edgeggrr/Miners-Safety-Helmet/images/PCB.png

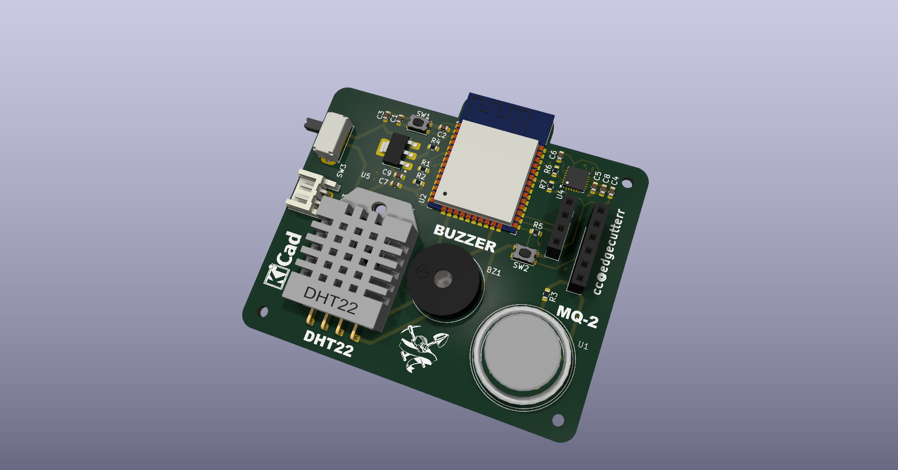
images/PCB.png
