edgeggrr/Miners-Safety-Helmet/PCB/CAD/Sparkfun BOB-08891.step

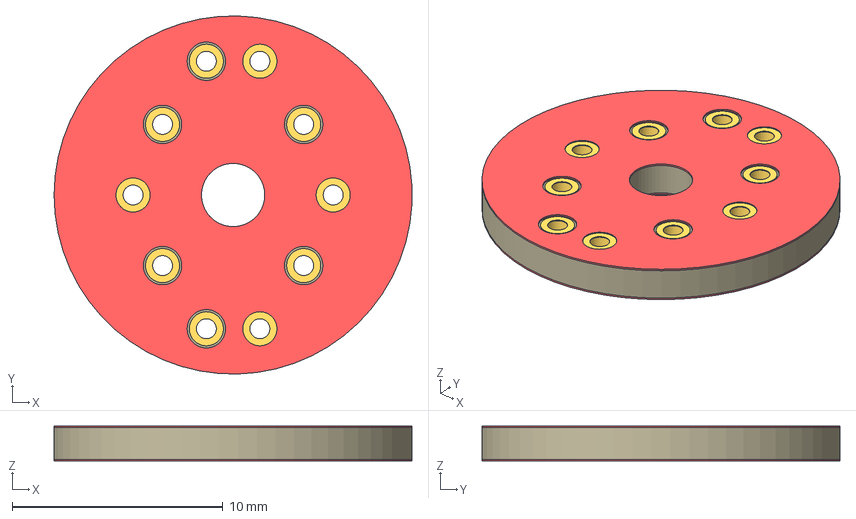
[picture p4: CAD file, 2026-10-25]
PCB/CAD/Sparkfun BOB-08891.step
17.0 x 17.0 x 1.66 mm
Board
1-copper
64-copper
1-soldermask
64-soldermask
