edgeggrr/Miners-Safety-Helmet/PCB/CAD/Sparkfun BOB-08891 with Sensor.step

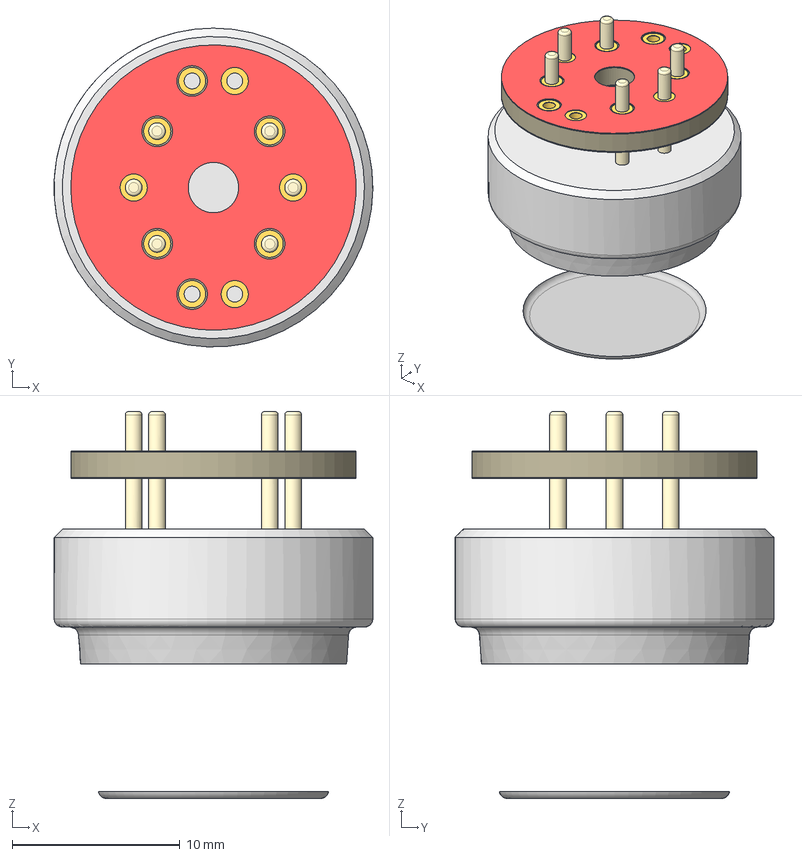
[picture p5: CAD file, 2026-10-25]
PCB/CAD/Sparkfun BOB-08891 with Sensor.step
19.0 x 19.0 x 23.1 mm
Board
1-copper
64-copper
1-soldermask
64-soldermask
