edgeggrr/Miners-Safety-Helmet/PCB/CAD/Buzzer_HC-12085.STEP

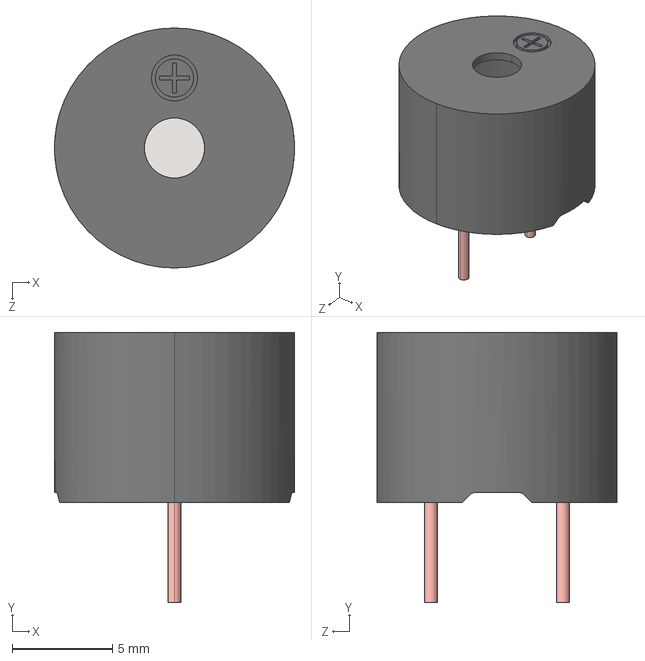
[picture p6: CAD file, 2026-10-25]
PCB/CAD/Buzzer_HC-12085.STEP
12.0 x 13.5 x 12.0 mm
