edgeggrr/Miners-Safety-Helmet/(list of files, drawings)

Other design files:
PCB/sch_data.json
