edgeggrr/Miners-Safety-Helmet/PCB/PCB.kicad_pcb

## KiCad design PCB/PCB.kicad_pcb (2026-11-10)

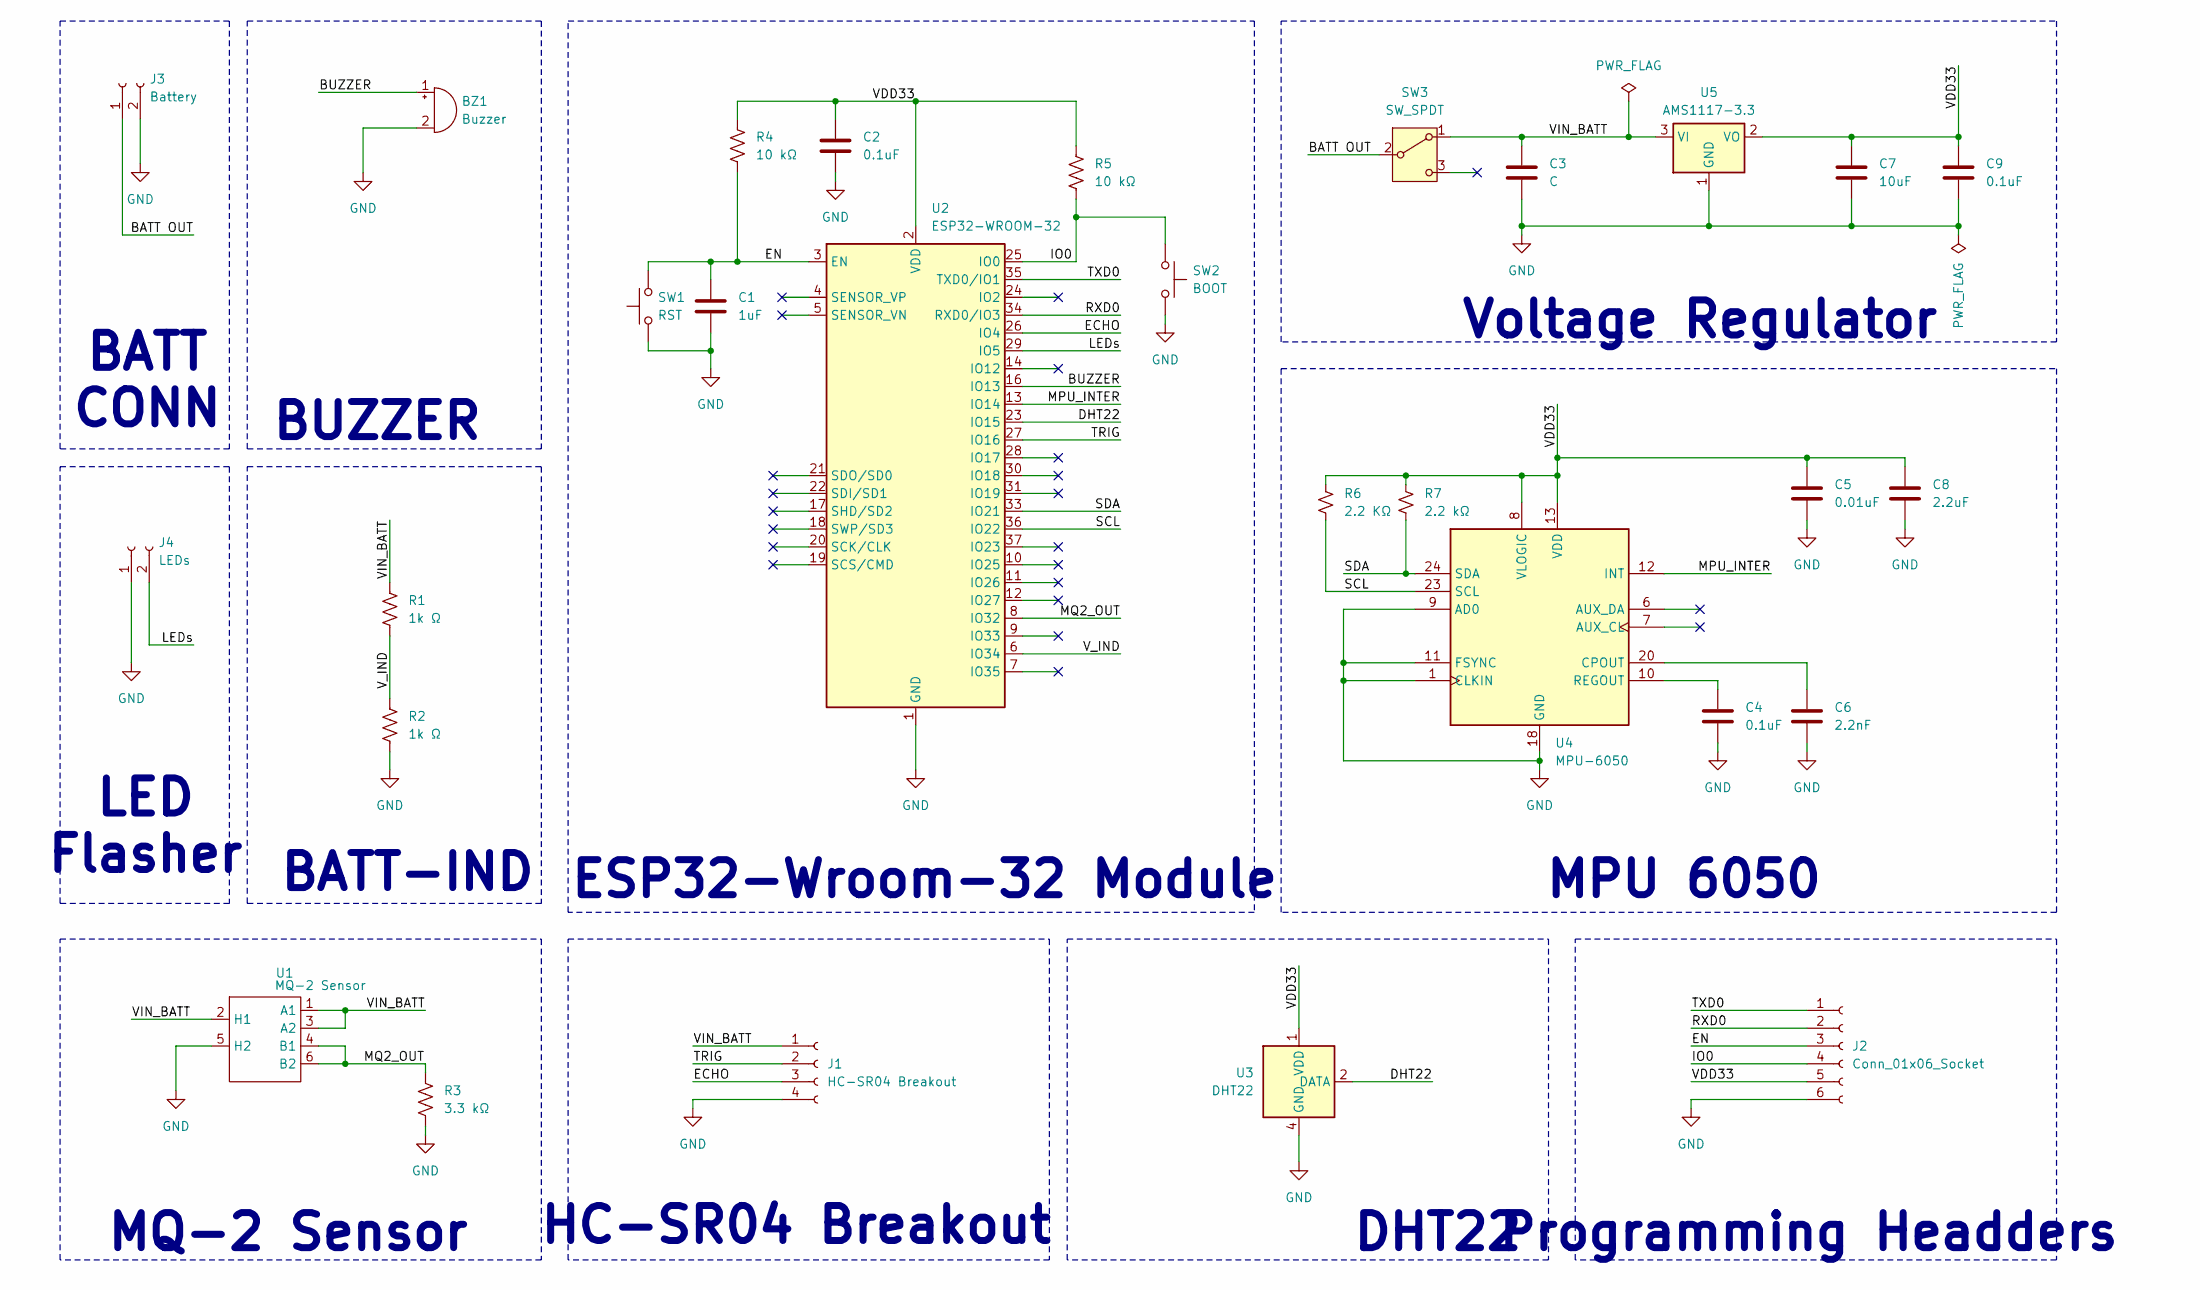
[picture p7: schematic PCB.kicad_sch, Miners Safety Helmet]

Parts:
BZ1: Buzzer; Buzzer_D14mm_H7mm_P10mm
C1: 1uF; C_0603_1608Metric
C2, C4, C9: 0.1uF; C_0603_1608Metric
C3: C; C_0603_1608Metric
C5: 0.01uF; C_0603_1608Metric
C6: 2.2nF; C_0603_1608Metric
C7: 10uF; C_0603_1608Metric
C8: 2.2uF; C_0603_1608Metric
J1: HC-SR04 Breakout; PinSocket_1x04_P2.54mm_Vertical
J2: Conn_01x06_Socket; PinSocket_1x06_P2.54mm_Vertical
J3: Battery; JST_EH_S2B-EH_1x02_P2.50mm_Horizontal
J4: LEDs; JST_PH_S2B-PH-K_1x02_P2.00mm_Horizontal
R1, R2: 1k Ω; R_0603_1608Metric
R3: 3.3 kΩ; R_0603_1608Metric
R4, R5: 10 kΩ; R_0603_1608Metric
R6: 2.2 KΩ; R_0603_1608Metric
R7: 2.2 kΩ; R_0603_1608Metric
SW1: RST; SW_Push_1P1T_NO_CK_KMR2
SW2: BOOT; SW_Push_1P1T_NO_CK_KMR2
SW3: SW_SPDT; SW_Slide_SPDT_Angled_CK_OS102011MA1Q
U1: MQ-2 Sensor; MQ2
U2: ESP32-WROOM-32
U3: DHT22; DHT22_Horizontal
U4: MPU-6050; InvenSense_QFN-24_4x4mm_P0.5mm
U5: AMS1117-3.3; SOT-223-3_TabPin2

Connections:
/BATT OUT: J3.1, SW3.2 (B)
/BUZZER: BZ1.1 (+), U2.16 (IO13)
/DHT22: U2.23 (IO15), U3.2 (DATA)
/ECHO: J1.3, U2.26 (IO4)
/EN: C1.1, J2.3, R4.1, SW1.2, U2.3 (EN)
/IO0: J2.4, R5.1, SW2.1, U2.25 (IO0)
/LEDs: J4.2, U2.29 (IO5)
/MPU_INTER: U2.13 (IO14), U4.12 (INT)
/MQ2_OUT: R3.2, U1.4 (B1), U1.6 (B2), U2.8 (IO32)
/RXD0: J2.2, U2.34 (RXD0/IO3)
/SCL: R6.2, U2.36 (IO22), U4.23 (SCL)
/SDA: R7.2, U2.33 (IO21), U4.24 (SDA)
/TRIG: J1.2, U2.27 (IO16)
/TXD0: J2.1, U2.35 (TXD0/IO1)
/VDD33: C2.1, C5.1, C7.1, C8.1, C9.1, J2.5, R4.2, R5.2, R6.1, R7.1, U2.2 (VDD), U3.1 (VDD), U4.8 (VLOGIC), U4.13 (VDD), U5.2 (VO)
/VIN_BATT: C3.1, J1.1, R1.1, SW3.1 (A), U1.1 (A1), U1.2 (H1), U1.3 (A2), U5.3 (VI)
/V_IND: R1.2, R2.1, U2.6 (IO34)
GND: BZ1.2 (-), C1.2, C2.2, C3.2, C4.2, C5.2, C6.2, C7.2, C8.2, C9.2, J1.4, J2.6, J3.2, J4.1, R2.2, R3.1, SW1.1, SW2.2, U1.5 (H2), U2.1 (GND), U2.15 (GND), U2.38 (GND), U2.39 (GND), U3.4 (GND), U4.1 (CLKIN), U4.9 (AD0), U4.11 (FSYNC), U4.18 (GND), U5.1 (GND)
unnamed: C6.1, U4.20 (CPOUT)
unnamed: C4.1, U4.10 (REGOUT)

Notes on the sheet:
MPU 6050
BUZZER
HC-SR04 Breakout
ESP32-Wroom-32 Module
Programming Headders
DHT22
MQ-2 Sensor
Voltage Regulator
BATT-IND
BATT CONN
LED Flasher

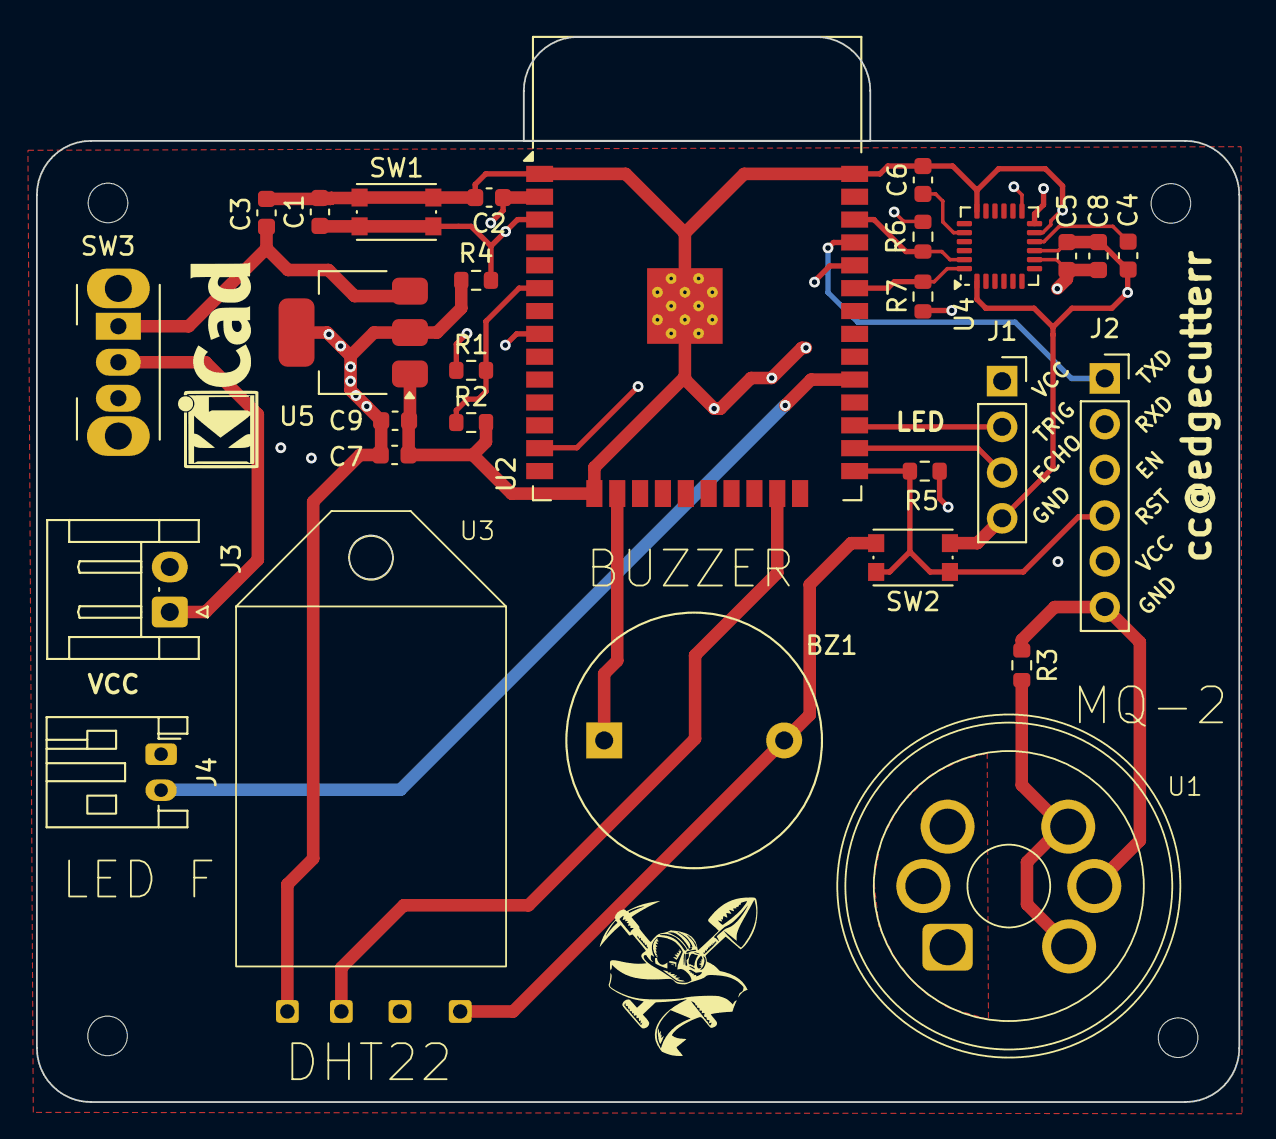
[picture p8: board PCB.kicad_pcb from above]

Board: 4 copper layers, 66.8 x 53.4 mm, 29 parts (0 on the bottom side), 20 nets.
