edgeggrr/Miners-Safety-Helmet/Firmware/main/secrets.h

#pragma once

/* ------------------------- WiFi / ThingSpeak Credentials ------------------------- */
#define WIFI_SSID           "YOUR_WIFI_SSID"
#define WIFI_PASSWORD       "YOUR_WIFI_PASSWORD"
#define THINGSPEAK_API_KEY  "YOUR_THINGSPEAK_API_KEY"
#define THINGSPEAK_URL      "http://api.thingspeak.com/update"
