edgeggrr/Miners-Safety-Helmet/(commit log)

2026-09-21 [ ADDED ] Project structre for PCB design
    - Added Project Structure for PCB using KiCad
    - Restructured Codebase as of Firmware and PCB design
    [PCB.kicad_pcb, PCB.kicad_sch]
2026-10-04 Ignore KiCad auto-generated history files
    [PCB.kicad_sch]
2026-10-04 [ADDED] Added MPU6050, Voltage Regulator, MCU
    - Integrated ESP32-WROOM-32 module.- Integrated MPU6050 6 DOF Accelerometer & Gyroscope Module.
2026-10-10 [ADDED] Sensors and Footprints Assignments
    - Added sensors like mq 2 dht 22 and hcsr 04
    - Assigned footprints for registration capacitors with 1608 metric sizes
    - Created custom footprint and symbol for MQ2 sensor
2026-10-25 [ADDED] PCB Design Completed
2026-10-25 Add PCB image to README
    Added an image of the PCB to the README.
2026-11-10 [ADDED] LED Flasher for PCB
    - Added 1.27mm Qwic connector for Led Flaser to be mounted on outside of helmet.
    - Added Orignal PoC Prototype image
2026-11-11 Fix image extension for prototype PoC in README
    Corrected the image file extension for the prototype proof of concept.
